BryanMateo/acuamet/README.md

# acuamet
 Repositorio para proyecto de Tesis

Proyecto de Tesis Acuamet
