BryanMateo/acuamet/cliente-micro/diseños_pcb/pcb_botones/pcb_botones.pdf

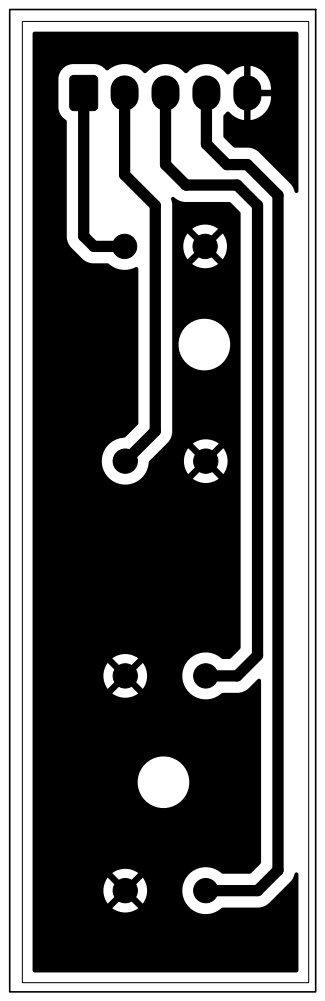
[picture p3: page 1]
