BryanMateo/acuamet/cliente-micro/diseños_3d/case_sensor_ultrasonico/case_sensor_v0/case.png

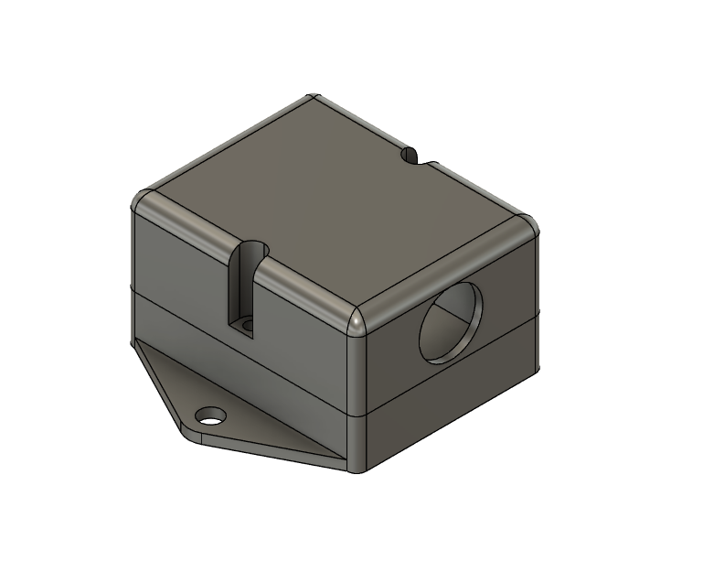
cliente-micro/diseños_3d/case_sensor_ultrasonico/case_sensor_v0/case.png
