BryanMateo/acuamet/cliente-micro/diseños_3d/case-acuamet/componentes-3d-model/modulo_relay_arduino/1 CH relay board.png

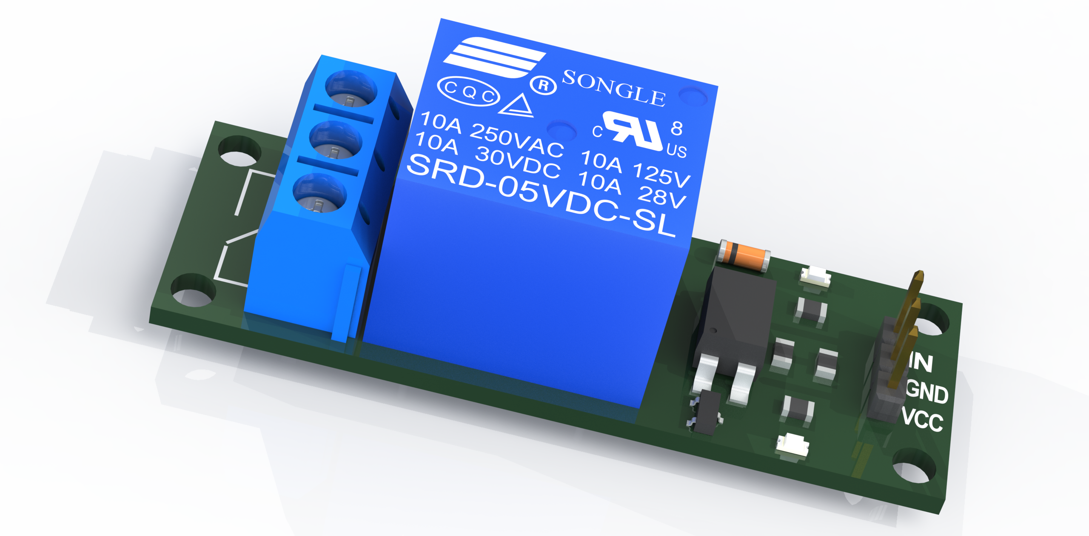
cliente-micro/diseños_3d/case-acuamet/componentes-3d-model/modulo_relay_arduino/1 CH relay board.png
