BryanMateo/acuamet/cliente-micro/diseños_3d/servovalvula/servoval_v2/Servovalvula v2.SLDASM

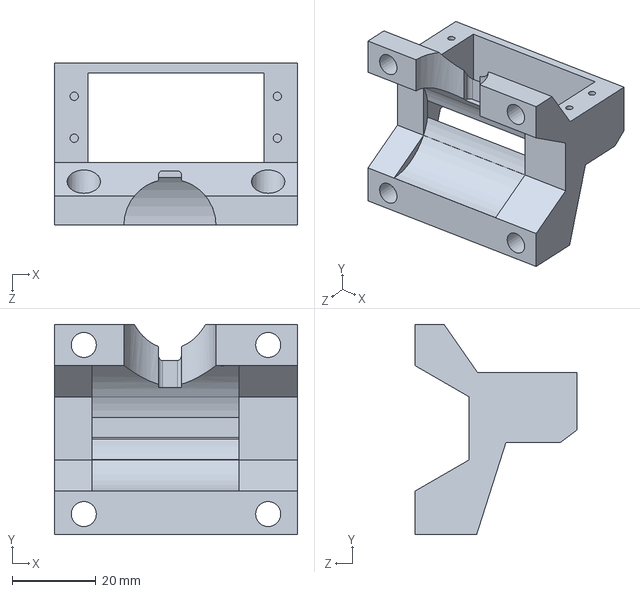
[picture p10: CAD file, 2025-04-15]
cliente-micro/diseños_3d/servovalvula/servoval_v2/Servovalvula v2.SLDASM
58.0 x 50.1 x 38.8 mm
