BryanMateo/acuamet/cliente-micro/diseños_3d/servovalvula/servoval_v2/Terminado/Servo/Servo.SLDASM

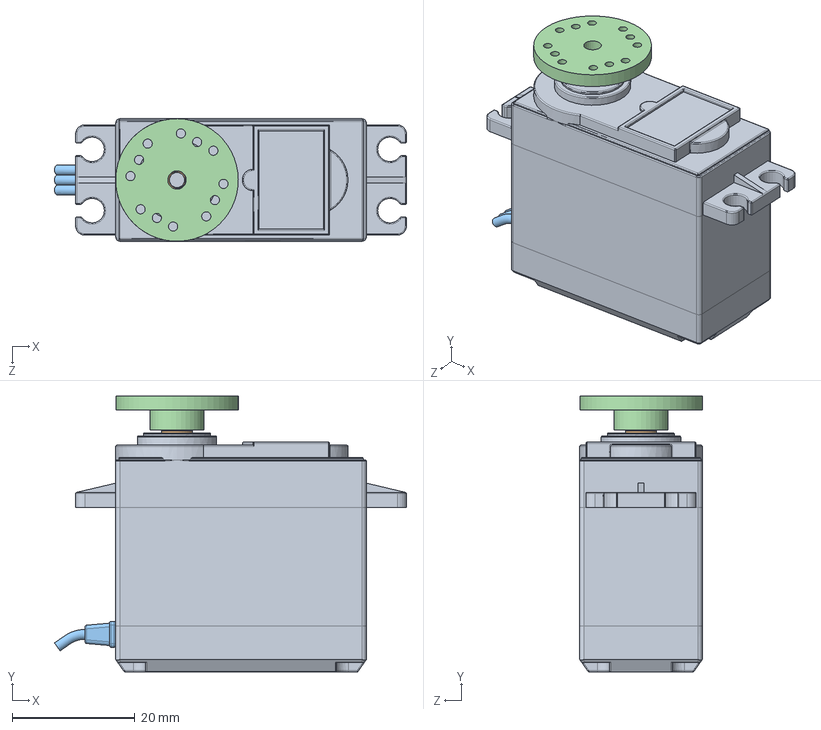
[picture p11: CAD file, 2025-04-15]
cliente-micro/diseños_3d/servovalvula/servoval_v2/Terminado/Servo/Servo.SLDASM
57.4 x 45.0 x 20.0 mm
Case
Output Shaft
Rubber Wire Cable Sleeve
Round horns
