BryanMateo/acuamet/cliente-micro/diseños_3d/case-acuamet/componentes-3d-model/fuente_5v/stl-fuente.stl

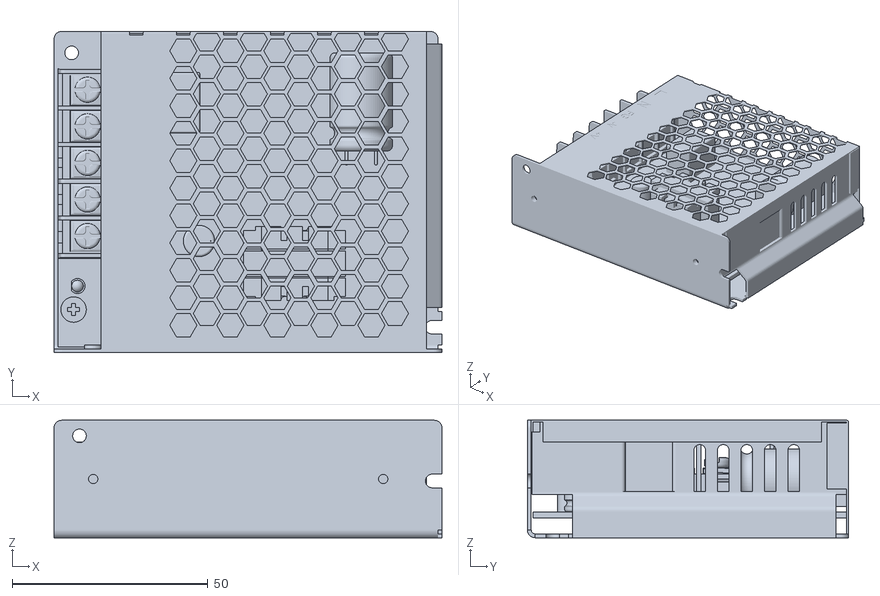
[picture p12: CAD file, 2025-04-14]
cliente-micro/diseños_3d/case-acuamet/componentes-3d-model/fuente_5v/stl-fuente.stl
99.0 x 82.0 x 30.0
