BryanMateo/acuamet/cliente-micro/diseños_3d/case-acuamet/componentes-3d-model/LCD/stl-lcd.stl

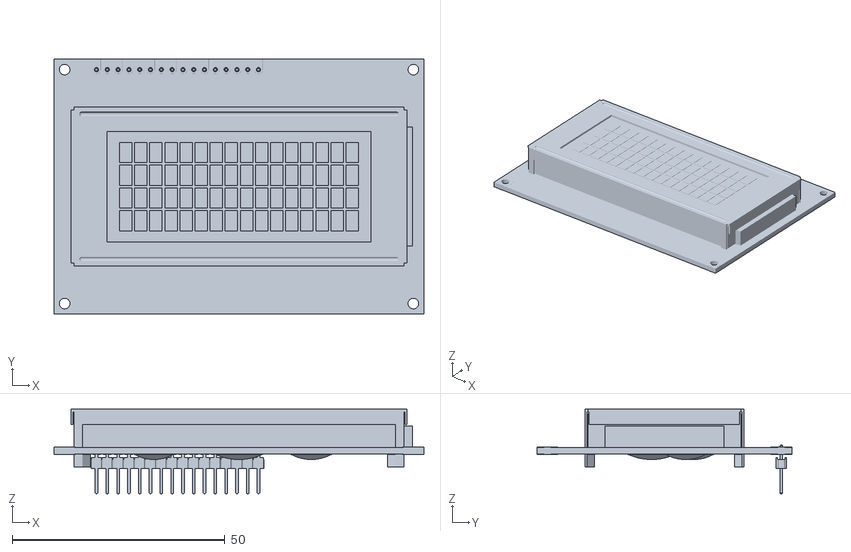
[picture p13: CAD file, 2025-04-14]
cliente-micro/diseños_3d/case-acuamet/componentes-3d-model/LCD/stl-lcd.stl
87.0 x 60.0 x 19.9
