BryanMateo/acuamet/cliente-micro/diseños_3d/case-acuamet/componentes-3d-model/modulo_relay_arduino/stl-relay.stl

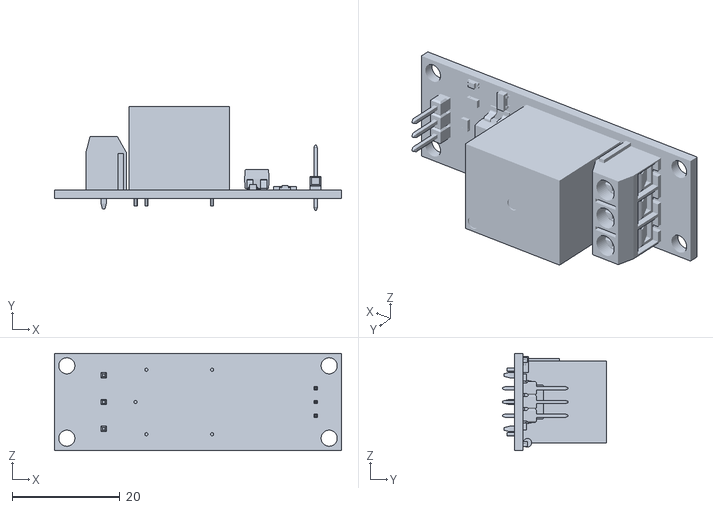
[picture p14: CAD file, 2025-04-14]
cliente-micro/diseños_3d/case-acuamet/componentes-3d-model/modulo_relay_arduino/stl-relay.stl
53.3 x 19.3 x 18.0
