BryanMateo/acuamet/cliente-micro/diseños_3d/case-acuamet/componentes-3d-model/PCB/pcb_cliente_micro_acuamet.3mf

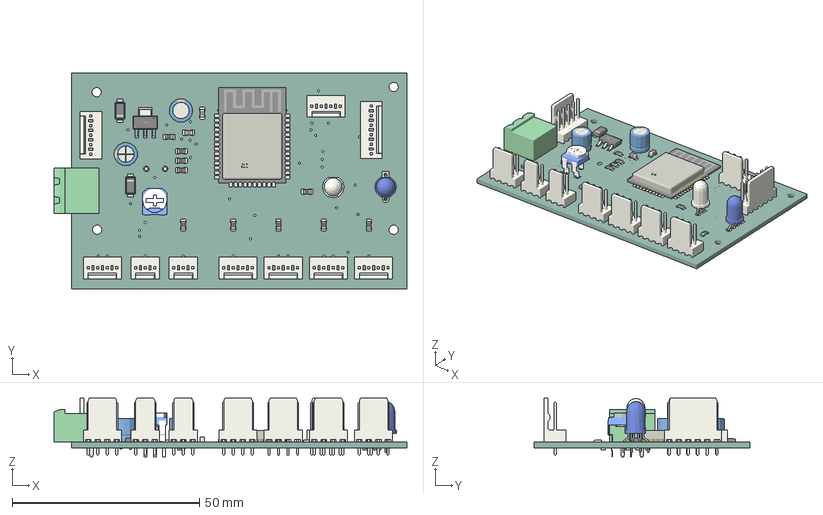
[picture p15: CAD file, 2025-04-13]
cliente-micro/diseños_3d/case-acuamet/componentes-3d-model/PCB/pcb_cliente_micro_acuamet.3mf
94.2 x 57.5 x 15.7 mm
CP_Radial_D6.3mm_P2.50mm x 2
LED_D5.0mm-4_RGB_Wide_Pins
Molex_KK-254_AE-6410-03A_1x03_P2.54mm_Vertical x 2
R_0805_2012Metric x 15
Molex_KK-254_AE-6410-04A_1x04_P2.54mm_Vertical x 6
SOT-223-4P_L6.5-W3.5-H1.6-LS7.0-P2.30 x 18
WIFI-SMD_L25.5-W18.0-H3.1-ESP32-WROOM-32E x 13
SMA_L4.5-W2.7-LS5.1-RD x 16
C_0805_2012Metric x 2
LED_D5.0mm_Clear
Molex_KK-254_AE-6410-05A_1x05_P2.54mm_Vertical
PhoenixContact_MSTBA_2,5_2-G-5,08_1x02_P5.08mm_Horizontal
RES-ADJ-SMD_RM065-V1
Molex_KK-254_AE-6410-06A_1x06_P2.54mm_Vertical
pcb_cliente_micro_acuamet_pad x 140
pcb_cliente_micro_acuamet_PCB
