BryanMateo/acuamet/cliente-micro/diseños_3d/case-acuamet/STL/Tope botones .stl

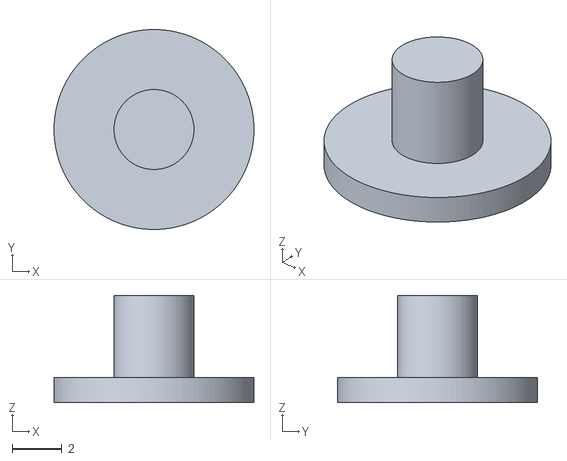
[picture p16: CAD file, 2025-04-16]
cliente-micro/diseños_3d/case-acuamet/STL/Tope botones .stl
8.00 x 8.00 x 4.30
