BryanMateo/acuamet/cliente-micro/diseños_3d/servovalvula/servoval_v2/Terminado/Servo/Round horns.SLDPRT

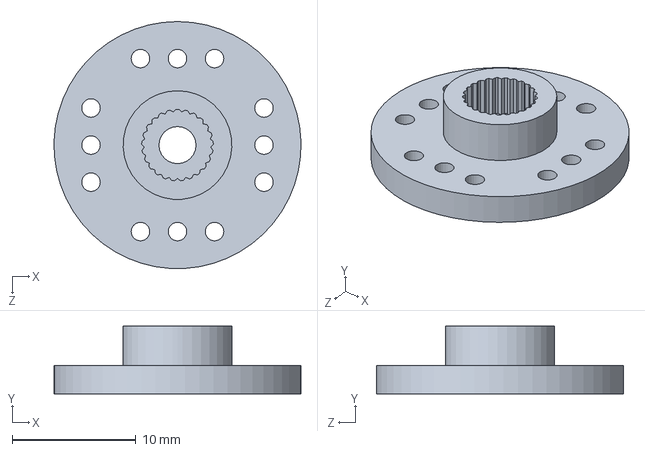
[picture p17: CAD file, 2025-04-15]
cliente-micro/diseños_3d/servovalvula/servoval_v2/Terminado/Servo/Round horns.SLDPRT
20.0 x 5.50 x 20.0 mm
