BryanMateo/acuamet/cliente-micro/diseños_3d/servovalvula/servoval_v2/Terminado/soporte valvula.SLDPRT

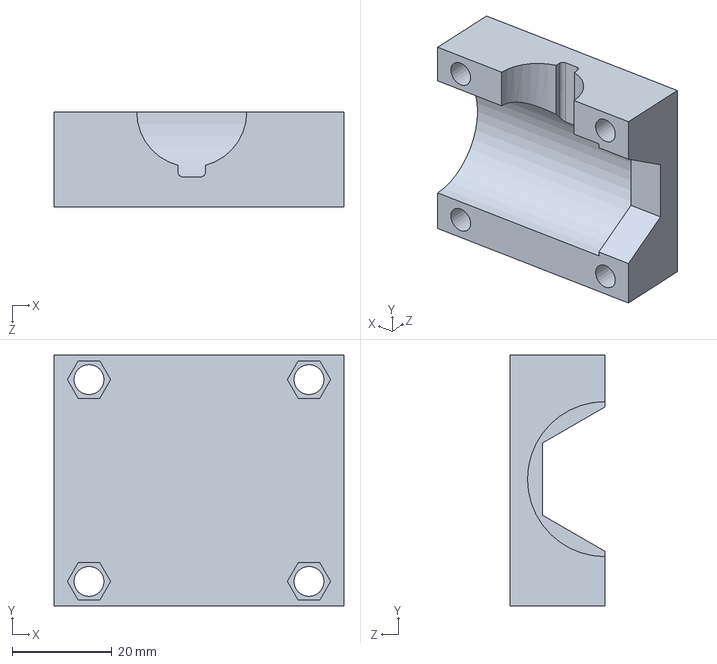
[picture p18: CAD file, 2025-04-21]
cliente-micro/diseños_3d/servovalvula/servoval_v2/Terminado/soporte valvula.SLDPRT
58.0 x 50.1 x 19.0 mm
