BryanMateo/acuamet/cliente-micro/diseños_3d/servovalvula/servoval_v2/Terminado/stl/Engranaje Servo.STL

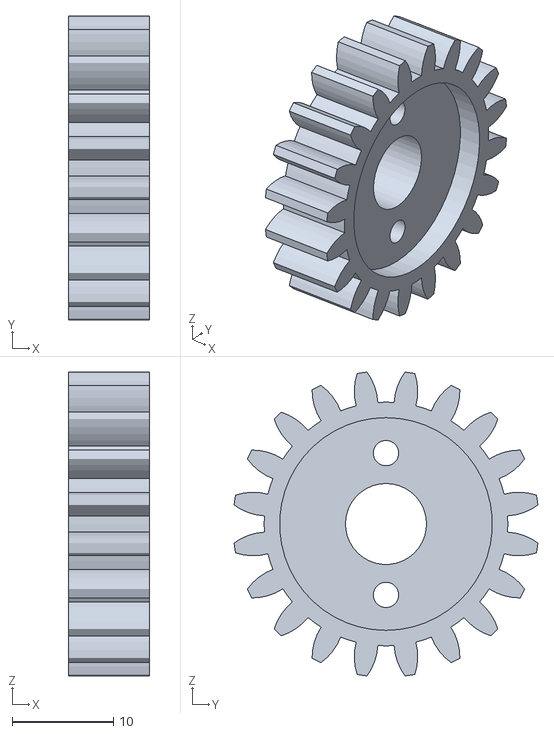
[picture p19: CAD file, 2025-04-14]
cliente-micro/diseños_3d/servovalvula/servoval_v2/Terminado/stl/Engranaje Servo.STL
8.00 x 30.0 x 30.0
