BryanMateo/acuamet/cliente-micro/diseños_pcb/pcb_bornera/pcb_bornera.step

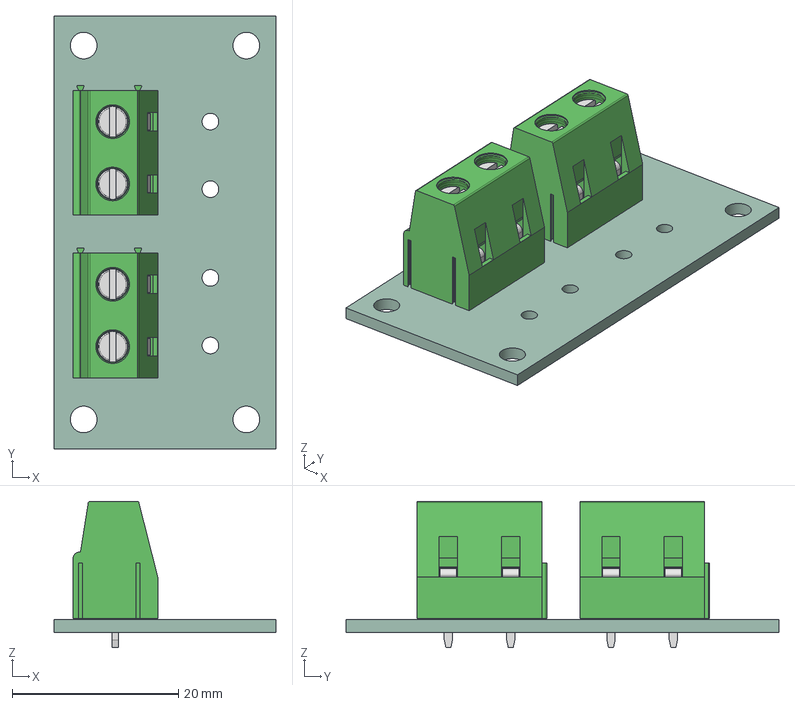
[picture p20: CAD file, 2025-04-15]
cliente-micro/diseños_pcb/pcb_bornera/pcb_bornera.step
26.7 x 52.1 x 17.6 mm
TB004-750-02GR x 2
pcb_bornera_PCB
