BryanMateo/acuamet/cliente-micro/diseños_pcb/pcb_botones/pcb_botones.step

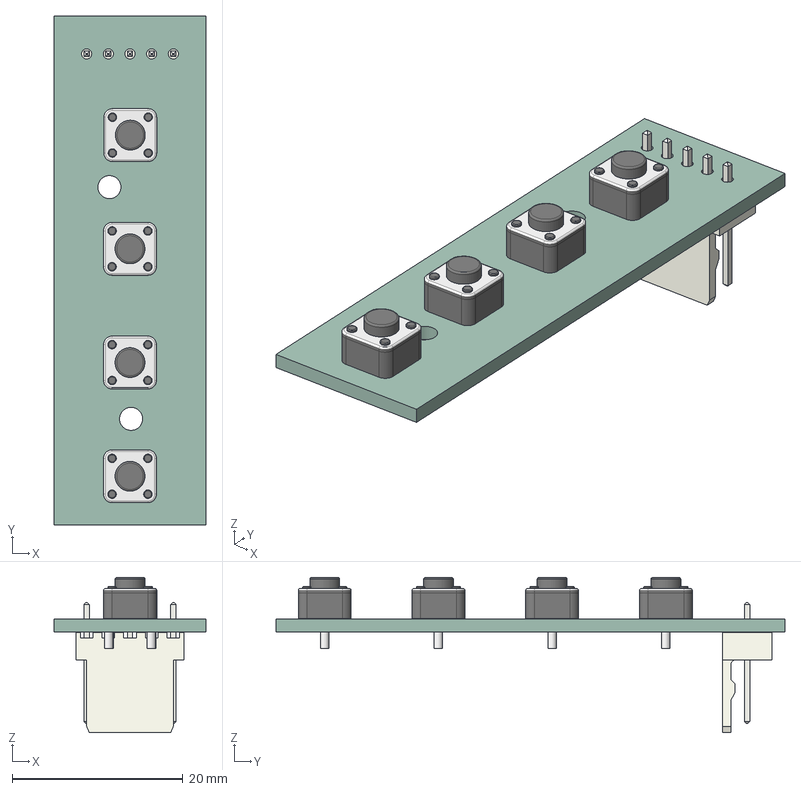
[picture p21: CAD file, 2025-04-14]
cliente-micro/diseños_pcb/pcb_botones/pcb_botones.step
17.8 x 59.7 x 18.2 mm
BUTT-2 x 4
Molex_KK-254_AE-6410-05A_1x05_P2.54mm_Vertical
pcb_botones_PCB
