BryanMateo/acuamet/cliente-micro/diseños_3d/case-acuamet/componentes-3d-model/modulo_relay_arduino/inserto tuerca .stl

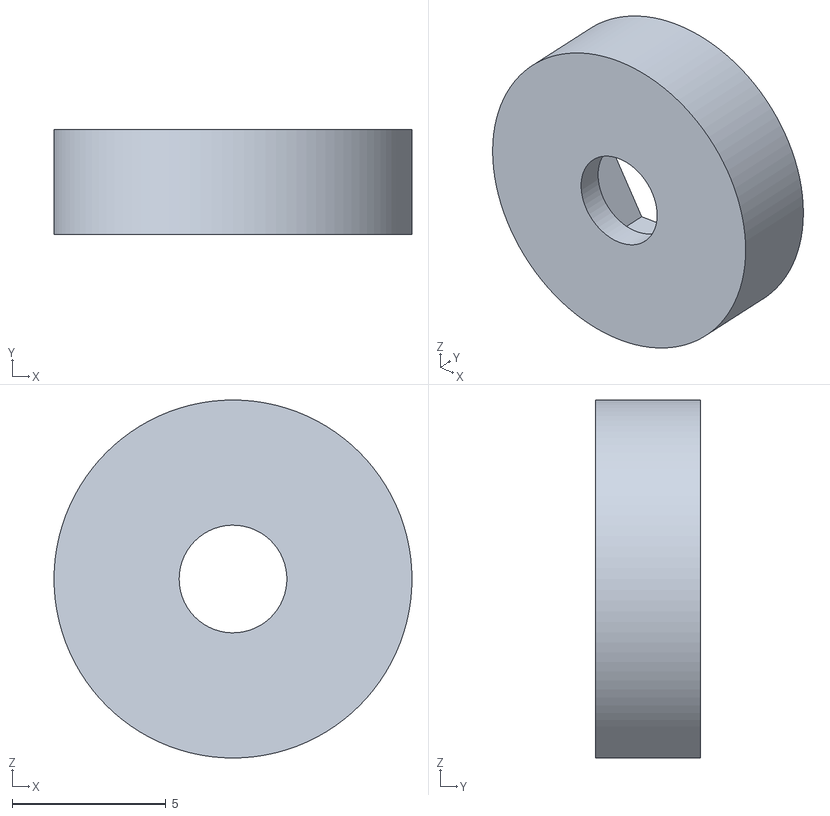
[picture p22: CAD file, 2025-04-14]
cliente-micro/diseños_3d/case-acuamet/componentes-3d-model/modulo_relay_arduino/inserto tuerca .stl
11.6 x 3.40 x 11.6
