BryanMateo/acuamet/cliente-micro/diseños_3d/case-acuamet/STL/botones pcb.stl

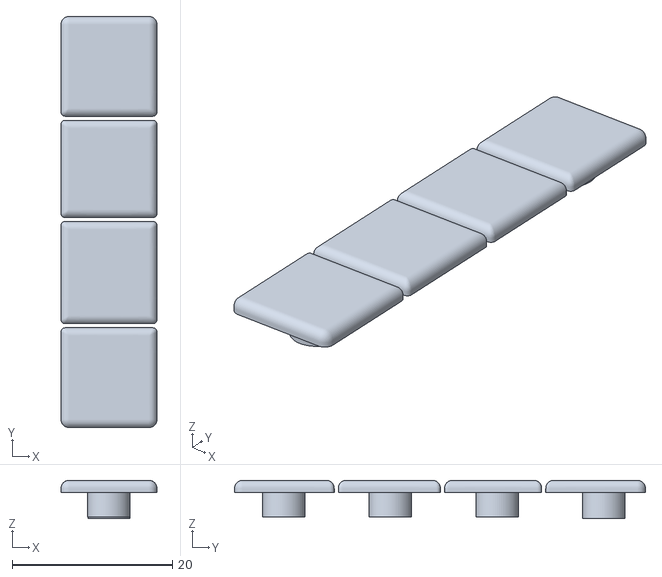
[picture p23: CAD file, 2025-04-16]
cliente-micro/diseños_3d/case-acuamet/STL/botones pcb.stl
12.0 x 51.4 x 4.80
