BryanMateo/acuamet/cliente-micro/diseños_3d/case-acuamet/STL/Case bottom.stl

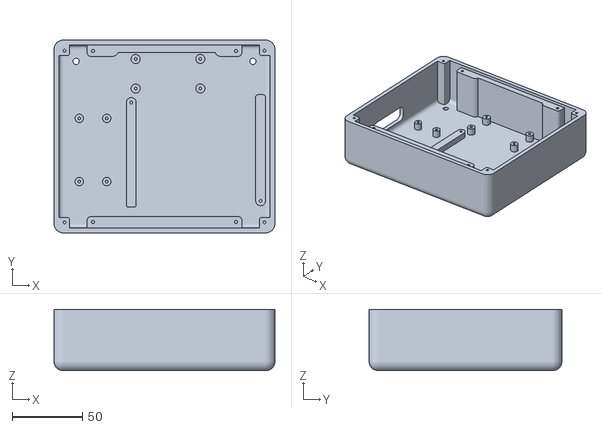
[picture p24: CAD file, 2025-04-16]
cliente-micro/diseños_3d/case-acuamet/STL/Case bottom.stl
157.2 x 137.2 x 43.6
