BryanMateo/acuamet/cliente-micro/diseños_3d/servovalvula/servoval_v2/Terminado/Conector - Engranaje.SLDPRT

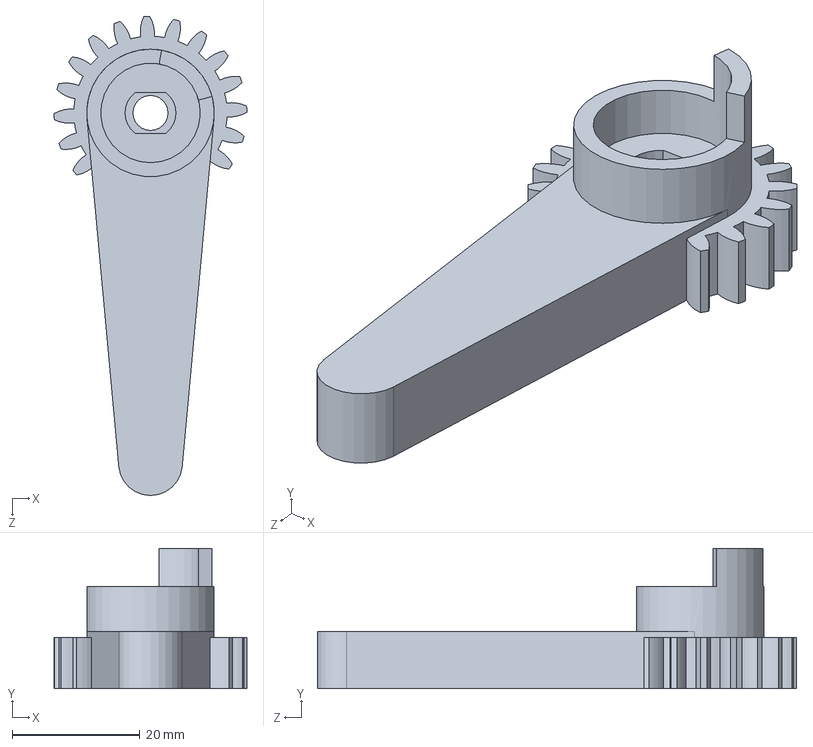
[picture p25: CAD file, 2025-04-16]
cliente-micro/diseños_3d/servovalvula/servoval_v2/Terminado/Conector - Engranaje.SLDPRT
30.2 x 22.0 x 75.1 mm
