BryanMateo/acuamet/cliente-micro/diseños_3d/case-acuamet/STL/Base PCB.stl

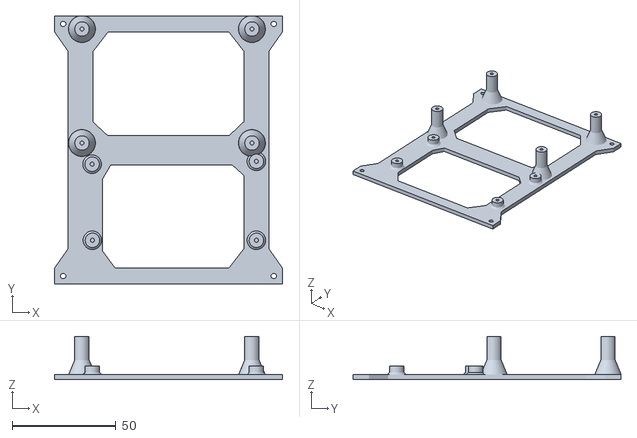
[picture p26: CAD file, 2025-04-16]
cliente-micro/diseños_3d/case-acuamet/STL/Base PCB.stl
110.0 x 129.2 x 20.9
