BryanMateo/acuamet/cliente-micro/diseños_3d/case-acuamet/STL/Case Top.stl

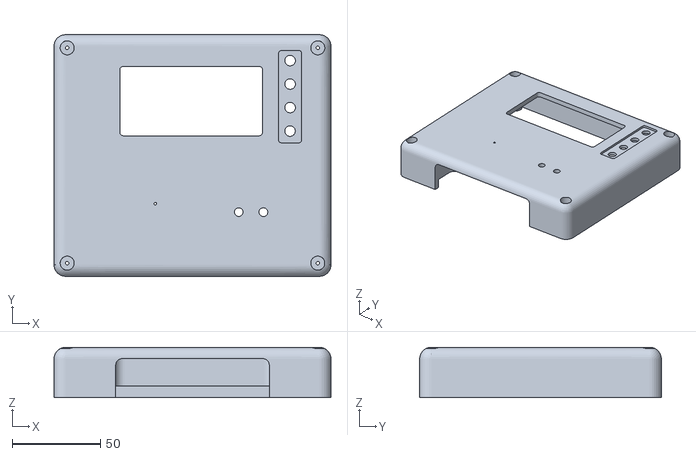
[picture p27: CAD file, 2025-04-16]
cliente-micro/diseños_3d/case-acuamet/STL/Case Top.stl
157.2 x 137.2 x 28.6
