BryanMateo/acuamet/cliente-micro/diseños_3d/case-acuamet/STL/Archivo slicer.3mf

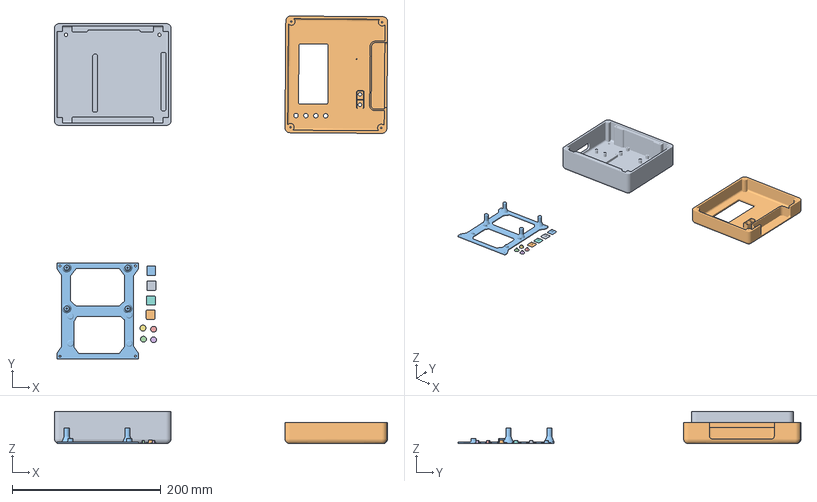
[picture p28: CAD file, 2025-04-16]
cliente-micro/diseños_3d/case-acuamet/STL/Archivo slicer.3mf
448.8 x 461.8 x 43.6 mm
Case bottom.stl
Case Top.stl
Base PCB.stl
Tope botones .stl x 4
botones pcb.stl_1
botones pcb.stl_2
botones pcb.stl_3
botones pcb.stl_4
