BryanMateo/acuamet/(list of files, cad)

Other CAD files:
cliente-micro/diseños_3d/case-acuamet/componentes-3d-model/fuente_5v/LRS-50-Series(MW).stp
cliente-micro/diseños_3d/servovalvula/servoval_v2/Terminado/Base soporte servo-valvula.SLDPRT
cliente-micro/diseños_3d/servovalvula/servoval_v2/Terminado/Servo/Rubber Wire Cable Sleeve.SLDPRT
cliente-micro/diseños_3d/servovalvula/servoval_v2/Terminado/Servo/Case.SLDPRT
cliente-micro/diseños_3d/servovalvula/servoval_v2/Terminado/Servo/Output Shaft.SLDPRT
cliente-micro/diseños_3d/case-acuamet/componentes-3d-model/PCB/pcb_cliente_micro_acuamet v1.f3d
cliente-micro/diseños_3d/case_sensor_ultrasonico/case_sensor_v0/Case sensor ultrasonico v0.f3d
cliente-micro/diseños_3d/servovalvula/servoval_v1/Base servoval v1.f3d
cliente-micro/diseños_3d/servovalvula/servoval_v1/Base servoval v1.step
cliente-micro/diseños_3d/servovalvula/servoval_v2/Terminado/stl/Base soporte servo-valvula.STL
cliente-micro/diseños_3d/servovalvula/servoval_v2/Terminado/stl/Conector - Engranaje.STL
cliente-micro/diseños_3d/servovalvula/servoval_v2/Terminado/stl/Soporte Valvula.STL
