BryanMateo/acuamet/cliente-micro/diseños_pcb/pcb_bornera/pcb_bornera-B_Cu.pdf

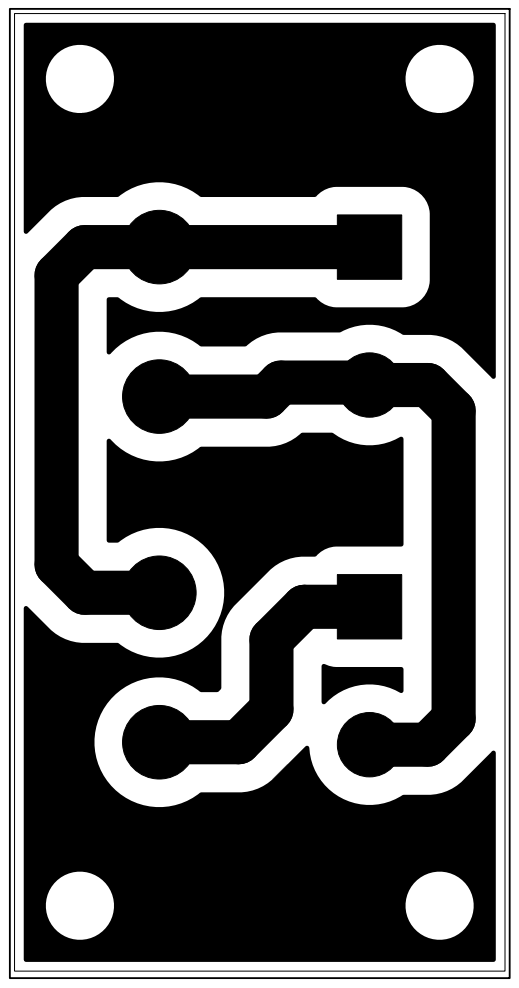
[picture p29: page 1]
