BryanMateo/acuamet/cliente-micro/diseños_pcb/pcb_cliente_micro_acuamet/PLOT/pcb_cliente_micro_acuamet-B_Cu.pdf

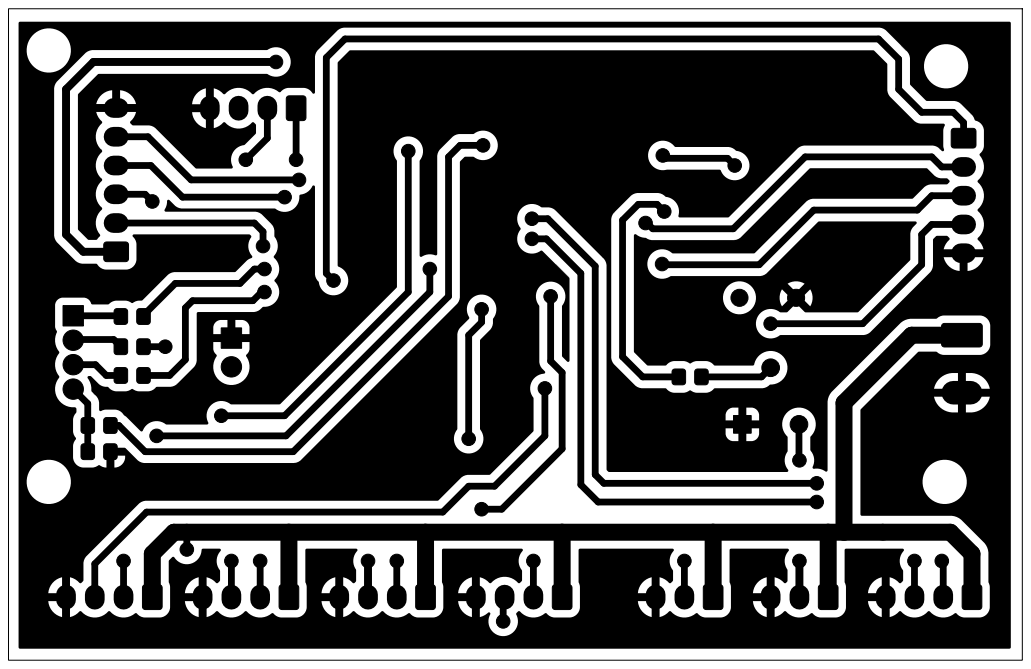
[picture p30: page 1]
