BryanMateo/acuamet/cliente-micro/diseños_pcb/pcb_cliente_micro_acuamet/PLOT/pcb_cliente_micro_acuamet-F_Cu.pdf

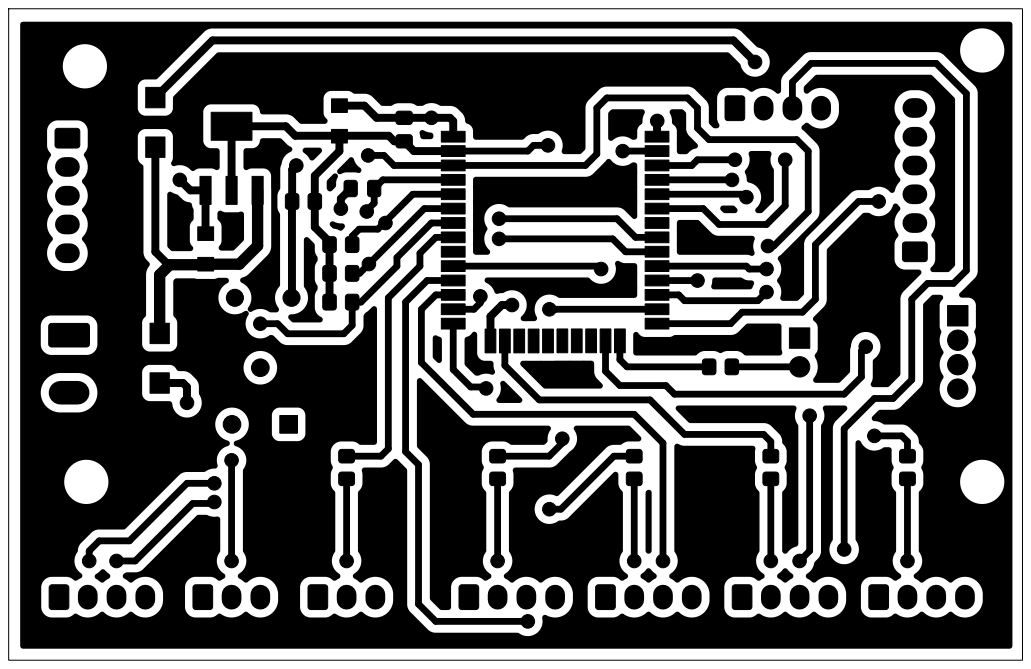
[picture p31: page 1]
