BryanMateo/acuamet/cliente-micro/diseños_pcb/pcb_bornera/pcb_bornera.kicad_pcb

## KiCad design cliente-micro/diseños_pcb/pcb_bornera/pcb_bornera.kicad_pcb (2025-04-23)

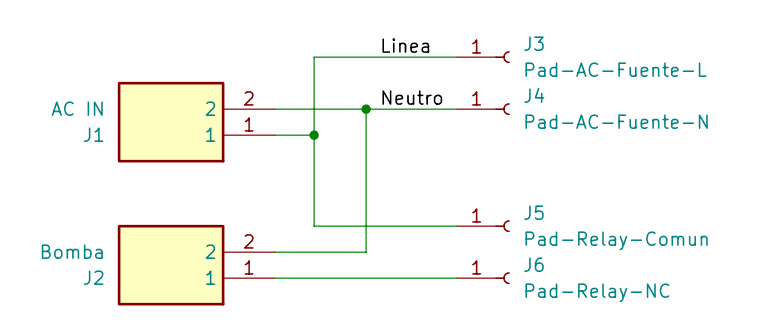
[picture p32: schematic pcb_bornera.kicad_sch]

Parts:
J1: AC IN; TB00475002GR; Mouser Part Number 179-TB004-750-02GR
J2: Bomba; TB00475002GR; Mouser Part Number 179-TB004-750-02GR
J3: Pad-AC-Fuente-L; TestPoint_THTPad_D4.0mm_Drill2.0mm
J4: Pad-AC-Fuente-N; TestPoint_THTPad_D4.0mm_Drill2.0mm
J5: Pad-Relay-Comun; TestPoint_THTPad_D4.0mm_Drill2.0mm
J6: Pad-Relay-NC; TestPoint_THTPad_D4.0mm_Drill2.0mm

Connections:
/Linea: J1.1, J3.1, J5.1
/Neutro: J1.2, J2.2, J4.1
unnamed: J2.1, J6.1

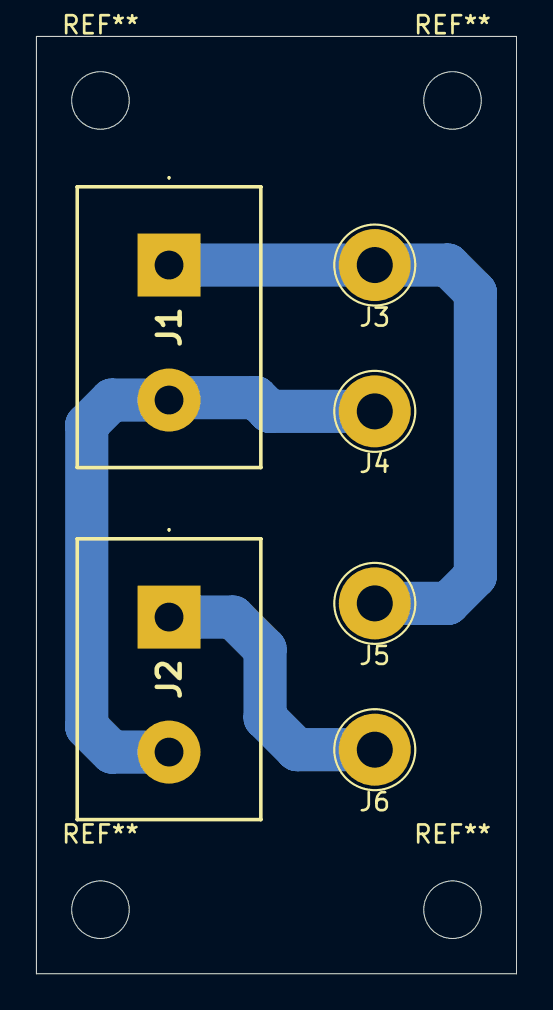
[picture p33: board pcb_bornera.kicad_pcb from above]

Board: 2 copper layers, 26.7 x 52.1 mm, 6 parts (0 on the bottom side), 3 nets.
