BryanMateo/acuamet/cliente-micro/diseños_pcb/pcb_botones/pcb_botones.kicad_pcb

## KiCad design cliente-micro/diseños_pcb/pcb_botones/pcb_botones.kicad_pcb (2025-04-23)

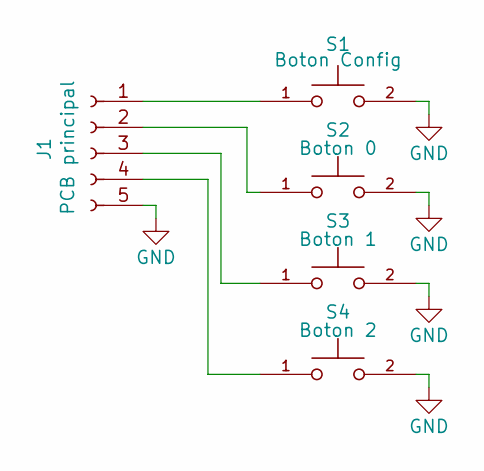
[picture p34: schematic pcb_botones.kicad_sch]

Parts:
J1: PCB principal; Molex_KK-254_AE-6410-05A_1x05_P2.54mm_Vertical
S1: Boton Config; BUTT-2_SW_BUTT-2; PARTREV N/A
S2: Boton 0; BUTT-2_SW_BUTT-2; PARTREV N/A
S3: Boton 1; BUTT-2_SW_BUTT-2; PARTREV N/A
S4: Boton 2; BUTT-2_SW_BUTT-2; PARTREV N/A

Connections:
GND: J1.5, S1.2, S2.2, S3.2, S4.2
unnamed: J1.1, S1.1
unnamed: J1.2, S2.1
unnamed: J1.3, S3.1
unnamed: J1.4, S4.1

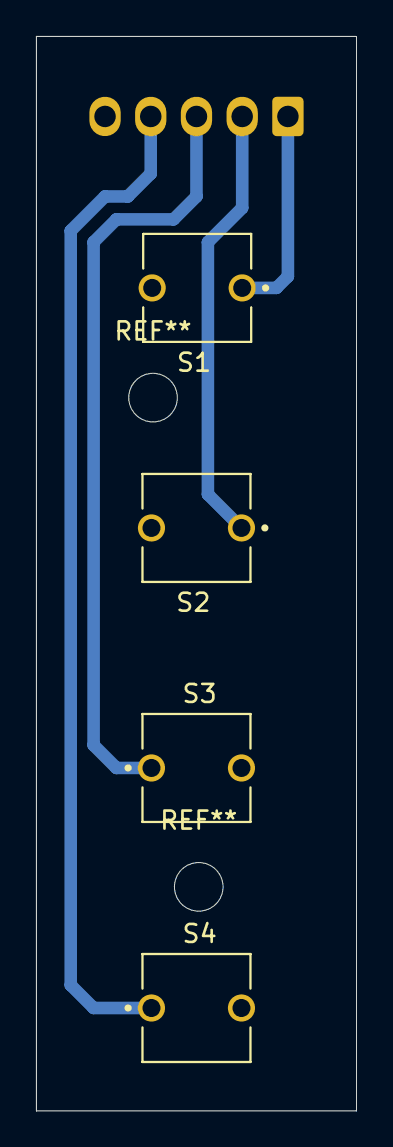
[picture p35: board pcb_botones.kicad_pcb from above]

Board: 2 copper layers, 17.8 x 59.7 mm, 5 parts (1 on the bottom side), 5 nets.
