BryanMateo/acuamet/cliente-micro/diseños_pcb/pcb_cliente_micro_acuamet/pcb_cliente_micro_acuamet.kicad_pcb

## KiCad design cliente-micro/diseños_pcb/pcb_cliente_micro_acuamet/pcb_cliente_micro_acuamet.kicad_pcb (2025-04-12)

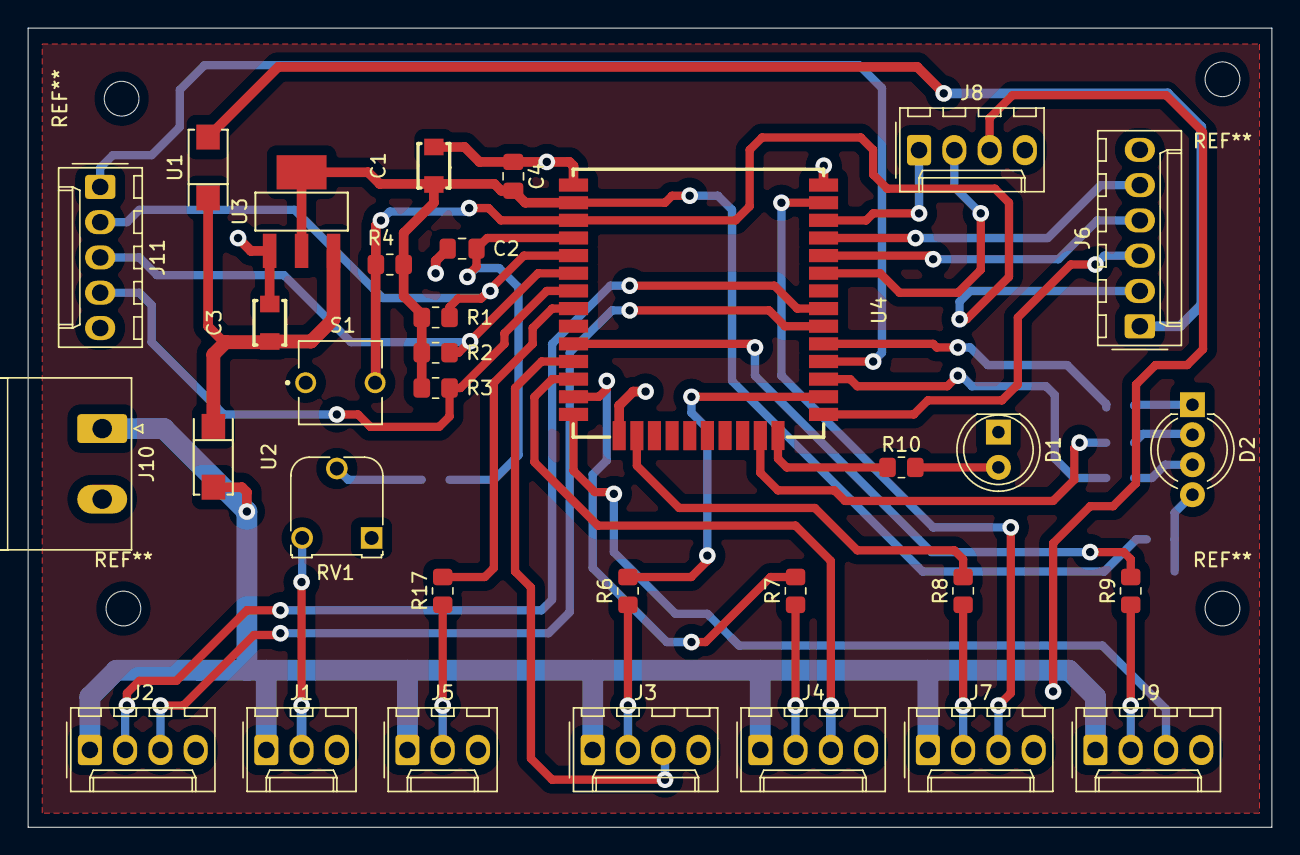
[picture p36: board pcb_cliente_micro_acuamet.kicad_pcb from above]

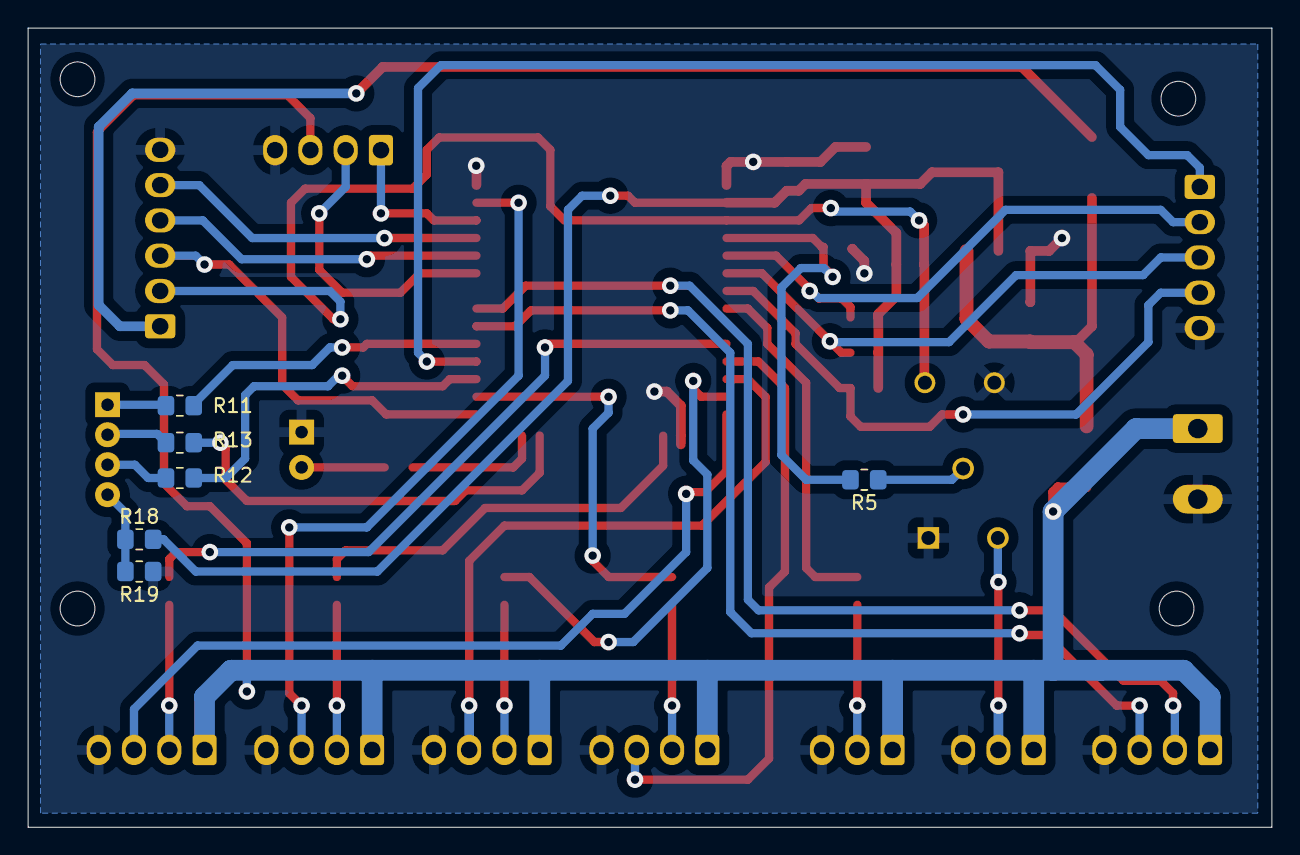
[picture p37: board pcb_cliente_micro_acuamet.kicad_pcb from below]

Board: 2 copper layers, 89.5 x 57.5 mm, 39 parts (6 on the bottom side), 43 nets.

Parts:
C1, C3: 10uF; CAP-SMD_L3.2-W1.6
C2, C4: 0.1uF; C_0805_2012Metric_Pad1.18x1.45mm_HandSolder
D1: Green LED; LED_D5.0mm_Clear
D2: LED_BRGK; LED_D5.0mm-4_RGB_Wide_Pins
J1: Presion; Molex_KK-254_AE-6410-03A_1x03_P2.54mm_Vertical
J2: Ultrasonico; Molex_KK-254_AE-6410-04A_1x04_P2.54mm_Vertical
J3: Valvula 1; Molex_KK-254_AE-6410-04A_1x04_P2.54mm_Vertical
J4: Valvula 2; Molex_KK-254_AE-6410-04A_1x04_P2.54mm_Vertical
J5: Relay; Molex_KK-254_AE-6410-03A_1x03_P2.54mm_Vertical
J6: Debug; Molex_KK-254_AE-6410-06A_1x06_P2.54mm_Vertical
J7: Valvula 3; Molex_KK-254_AE-6410-04A_1x04_P2.54mm_Vertical
J8: LCD; Molex_KK-254_AE-6410-04A_1x04_P2.54mm_Vertical
J9: Valvula 4; Molex_KK-254_AE-6410-04A_1x04_P2.54mm_Vertical
J10: 5V IN; PhoenixContact_MSTBA_2,5_2-G-5,08_1x02_P5.08mm_Horizontal
J11: Botones; Molex_KK-254_AE-6410-05A_1x05_P2.54mm_Vertical
R1, R2, R3, R4: 10K; R_0805_2012Metric_Pad1.20x1.40mm_HandSolder
R5, R17: 48.7; R_0805_2012Metric_Pad1.20x1.40mm_HandSolder
R6, R7, R8, R9, R10, R11, R12, R13: 1K; R_0805_2012Metric_Pad1.20x1.40mm_HandSolder
R18, R19: 0; R_0805_2012Metric_Pad1.20x1.40mm_HandSolder
RV1: 10K; Potentiometer_Runtron_RM-065_Vertical
S1: BUTT-2; BUTT-2_SW_BUTT-2
U1, U2: M7; SMA_L4.5-W2.7-LS5.1-RD
U3: AMS1117-3.3_C347222; SOT-223-4_L6.5-W3.5-P2.30-LS7.0-BR
U4: ESP32-WROOM-32D; WIFIM-SMD_39P-L25.5-W18.0-P1.27-BL

Connections:
+3.3V: C1.1, C4.2, R1.1, R2.1, R3.1, R4.1, R18.2, U3.2 (VOUT(TAB)), U3.4 (TAB), U4.2 (VDD33)
+5V: J1.1, J2.1, J3.1, J4.1, J5.1, J7.1, J8.3, J9.1, J10.1, U2.2
+5VD: J6.1, U1.2
/EN: J6.2, R4.2, S1.2, U4.3 (EN)
/IO0: J6.3, U4.25 (IO0)
/RXD0: J6.4, U4.34 (RXD0)
/TXD0: J6.5, U4.35 (TXD0)
/boton_0: J11.2, R1.2, U4.5 (SENSOR_VN)
/boton_1: J11.3, R2.2, U4.6 (IO34)
/boton_2: J11.4, R3.2, U4.7 (IO35)
/config_pin: J11.1, U4.28 (IO17)
/flujometro_1: R6.2, U4.26 (IO4)
/flujometro_2: R7.2, U4.13 (IO14)
/flujometro_3: R8.2, U4.16 (IO13)
/flujometro_4: R9.2, U4.10 (IO25)
/lcd_scl: J8.1, U4.36 (IO22)
/lcd_sda: J8.2, U4.33 (IO21)
/pwr_led: R10.1, U4.24 (IO2)
/relay_bomba: R17.2, U4.8 (IO32)
/sens_presion: C2.2, R5.2, U4.4 (SENSOR_VP)
/señal_led_b: R11.1, U4.29 (IO5)
/señal_led_g: R12.1, U4.27 (IO16)
/señal_led_r: R13.1, U4.23 (IO15)
/ultrasonico_echo: J2.3, U4.30 (IO18)
/ultrasonico_trig: J2.2, U4.31 (IO19)
/valvula_1: J3.3, U4.11 (IO26)
/valvula_2: J4.3, U4.12 (IO27)
/valvula_3: J7.3, U4.37 (IO23)
/valvula_4: J9.3, U4.14 (IO12)
GND: C1.2, C2.1, C3.2, C4.1, D1.1 (K), J1.3, J2.4, J3.4, J4.4, J5.3, J6.6, J7.4, J8.4, J9.4, J10.2, J11.5, R19.1, RV1.1, S1.1, U3.1 (ADJ(GND)), U4.1 (GND), U4.15 (GND), U4.38 (GND), U4.39 (GND)
unnamed: D1.2 (A), R10.2
unnamed: D2.1 (BA), R11.2
unnamed: D2.3 (GA), R12.2
unnamed: D2.4 (K), R18.1, R19.2
unnamed: D2.2 (RA), R13.2
unnamed: J1.2, RV1.3
unnamed: J3.2, R6.1
unnamed: J4.2, R7.1
unnamed: J5.2, R17.1
unnamed: J7.2, R8.1
unnamed: J9.2, R9.1
unnamed: R5.1, RV1.2
VCC: C3.1, U1.1, U2.1, U3.3 (VIN)
