BryanMateo/acuamet/cliente-micro/acuamet-cliente-esp32/main/src/lcd.h

#ifndef LCD_H
#define LCD_H
#include "../main.h"

#define i2c_lcd_port 0
#define i2c_lcd_address 0x27
#define lcd_cols 16
#define lcd_rows 4

// LCD module defines
#define LCD_LINEONE 0x00   // start of line 1
#define LCD_LINETWO 0x40   // start of line 2
#define LCD_LINETHREE 0x10 // start of line 3
#define LCD_LINEFOUR 0x50  // start of line 4

#define LCD_BACKLIGHT 0x08
#define LCD_ENABLE 0x04
#define LCD_COMMAND 0x00
#define LCD_WRITE 0x01

#define LCD_SET_DDRAM_ADDR 0x80
#define LCD_READ_BF 0x40

// LCD instructions
#define LCD_CLEAR 0x01             // replace all characters with ASCII 'space'
#define LCD_HOME 0x02              // return cursor to first position on first line
#define LCD_ENTRY_MODE 0x06        // shift cursor from left to right on read/write
#define LCD_DISPLAY_OFF 0x08       // turn display off
#define LCD_DISPLAY_ON 0x0C        // display on, cursor off, don't blink character
#define LCD_FUNCTION_RESET 0x30    // reset the LCD
#define LCD_FUNCTION_SET_4BIT 0x28 // 4-bit data, 2-line display, 5 x 7 font
#define LCD_SET_CURSOR 0x80        // set cursor position

void LCD_setCursor(uint8_t col, uint8_t row);
void LCD_init(uint8_t addr, uint8_t dataPin, uint8_t clockPin, uint8_t cols, uint8_t rows);

void LCD_home(void);
void LCD_clearScreen(void);
void LCD_writeChar(char c);
void LCD_writeStr(char *str);

#endif
