BryanMateo/acuamet/(commit log)

2025-02-10 configuracion inicial plataforma
    Punto de partida para la api y la pagina web del proyecto.
2025-03-17 Punto de partida ESP32
    1. AP-Pag web-Wifi config
    2. Conexion MQTT
    3. Creacion de topicos individuales con la MAC unica del ESP32
2025-03-18 FSM Implementada
    Limpieza del codigo y organizacion de las librerias y los headers.
    Implementacion de la estructura de la FSM en un task, y la definicion de los estados, faltan agregar las codiciones y return adecuados en cada una de las funciones/estados.
2025-03-18 Optimizacion Main.c, MQTT
    Limpieza, organizacion y optimizacion del codigo.
    Inclusion del MQTT al FSM, y creacion de flags de mqtt y wifi connected.
2025-03-19 Interrupciones para medir flujo
    Se utilizo interrupciones a la CPU con cada pulso del flujometro para sumar la cantidad de pulsos y calcular el flujo.
2025-03-20 Reemplazado las interrupciones por un contador por hardware PCNT.
    Se cambio el conteo de pulsos mediante interrupciones, al contador por hardware del esp32 PCNT.
2025-03-20 Implementado el contador de pulsos y litros en un task.
2025-03-22 Implementacion sens ultrasonico.
    Cambiado contador_pulsos a sensores.
    Implementado sensor ultrasonico con medida por promedio.
    Optimizacion de task.
2025-03-25 Sensor de presion agregado
    Se agrego la funcion para leer el sensor de presion usando ADC oneshot.
    Se cambio la tabla de particion del ESP de 1mb a 1.5mb.
2025-03-25 Implementados las estructuras de los sensores y salidas
    Creada la funcion de leer los pulsos de los flujometros y convertir a galones.
2025-03-26 Cambios a la fsm, y sensor de presion.
    Agregados estados online y offline.
    Sensor de presion por promedio.
2025-03-29 Agregado llave identificadora.
    Agregado llave o key unica para identificar cada usuario en los clientes.
    Agregada la configuracion de la llave en el cliente.
    Creacion de registro en la base de datos por la api, de cliente nuevo o actualizacion de llave de uno existente, y inicializacion de topicos de control.
2025-03-30 LCD implementado
    Implementado los comandos de control para el LCD
2025-04-07 Version 1 del PCB
    Version 1 del PCB.
    Limpieza de codigo y comentarios
    [pcb_cliente_micro_acuamet.kicad_pcb, pcb_cliente_micro_acuamet.kicad_sch]
2025-04-12 Version final PCB
    Version revisada y corregida
    [pcb_cliente_micro_acuamet.kicad_sch]
2025-04-12 Archivo .STEP PCB
    Archivo step del PCB actualizado
    [pcb_cliente_micro_acuamet.kicad_pcb]
2025-04-13 Carcasa sensor ultrasonico listo
    [Case sensor ultrasonico v0.f3d]
2025-04-13 Todos los diseños hasta la fecha
    [Base servoval v1.f3d, Case sensor ultrasonico v0.f3d, LCD_SCREEN_16x4.stl, LRS-50-Series(MW).stl, LRS-50-Series(MW).stp, pcb_cliente_micro_acuamet v1.f3d, pcb_cliente_micro_acuamet.3mf, pcb_cliente_micro_acuamet2.stl]
2025-04-13 Control de salidas
    Implementado control de salidas.
    Agregada estructura de flags para control, wifi, etc.
    Optimizado y funcionando json para la suscripcion mqtt.
2025-04-14 Correcion de recursos 3D
    [LCD_SCREEN_16x4.stl, LRS-50-Series(MW).stl, inserto tuerca .stl, pcb_cliente_micro_acuamet2.stl, stl-fuente.stl, stl-lcd.stl, stl-relay.stl]
2025-04-14 Servovalvula v2
    Rediseño de servovalvula
    [Base soporte servo-valvula.SLDPRT, Conector - Engranaje.SLDPRT, Conector - Engranaje.STL, Engranaje Servo.STL, Part12.SLDPRT]
2025-04-14 PCB para botones cliente
    [pcb_botones.kicad_pcb, pcb_botones.kicad_sch]
2025-04-14 STL Piezas servovalvula v2
    [Base soporte servo-valvula.STL, Conector - Engranaje.STL, Engranaje Servo.STL, Soporte Valvula.STL]
2025-04-15 PCB borneras AC
    PCB para entrada AC y salida de control por relay de la bomba en rango 110-240V AC.
    [pcb_bornera.kicad_pcb, pcb_bornera.kicad_sch, pcb_bornera.step]
2025-04-15 Organizacion de directorios.
    [Base soporte servo-valvula.SLDPRT, Case.SLDPRT, Conector - Engranaje.STL, Engranaje Servo.STL, Output Shaft.SLDPRT, Part12.SLDPRT, Round horns.SLDPRT, Rubber Wire Cable Sleeve.SLDPRT]
2025-04-16 Case terminado
    Version 1 del case terminado
    [Archivo slicer.3mf, Base PCB.stl, Case Top.stl, Case bottom.stl, Tope botones .stl, botones pcb.stl]
2025-04-16 Create Base servoval v1.step
    [Base servoval v1.step]
2025-04-16 Actualizado Servo Valvula v2
    [Base soporte servo-valvula.SLDPRT, Base soporte servo-valvula.STL, Conector - Engranaje.SLDPRT, Conector - Engranaje.STL, Soporte Valvula.STL, soporte valvula.SLDPRT]
2025-04-17 Conteo de consumo offline y en el servidor.
    Optimizada la FSM: Anulado estado wificonn, se inicializa el STA y el cliente mqtt en el init. Wifi y MQTT se mantienen reconectando en sus task.
    Estado online con un token para evitar sumar datos erroneos, que se guarda en la base de datos.
    Estado offline que guarda consumo en la NVS y el token anterior si existe. Posible token redundante en la flash (se podria eliminar de la nvs y solo guardar consumos).
    Implementacion en la api para sumar el consumo acumulado de cada cliente y asignar los token.
    Optimizacion general de codigo del ESP32.
2025-04-17 Task para LCD
    Task que va a manejar el LCD dependiendo del estado actual de la FSM
2025-04-18 Consumo acumulado online LCD
    Optimizacion de api.
    Consumo acumulado en lcd.
2025-04-21 Fix servovalvula
    [Base soporte servo-valvula.SLDPRT, Base soporte servo-valvula.STL, Soporte Valvula.STL, soporte valvula.SLDPRT]
2025-04-23 Plot PCB
    [pcb_bornera.kicad_pcb, pcb_botones.kicad_pcb]
2025-04-28 Terminacion de pagina web v1
